jbcznsk/7-segment-clock/imgs/m.png

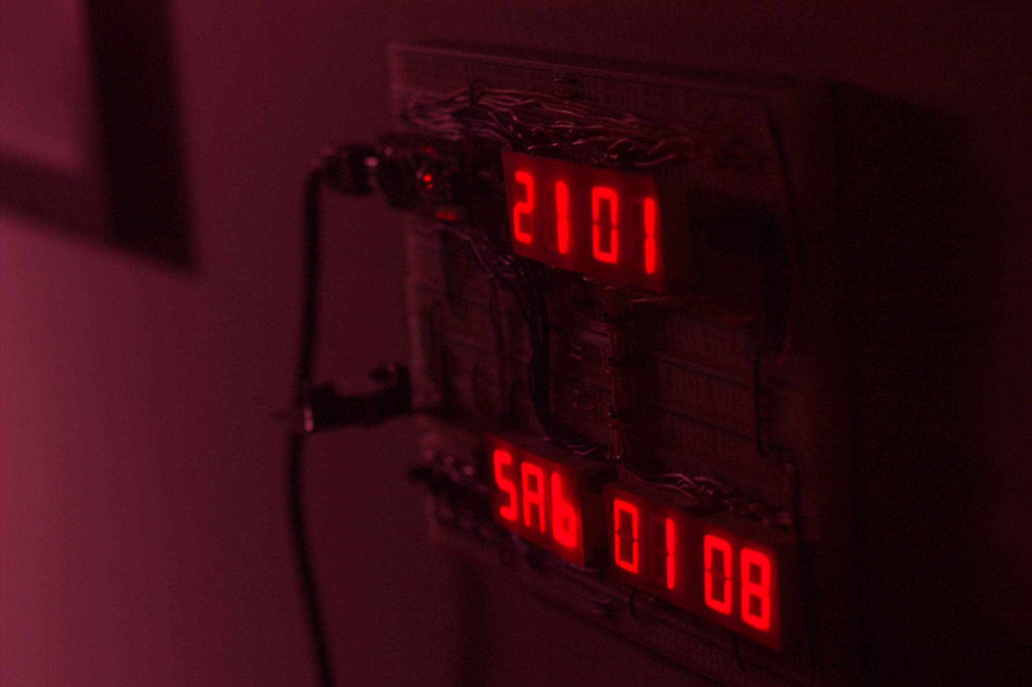
imgs/m.png
