jbcznsk/7-segment-clock/imgs/montagem/README.md

## Montagem do Circuito
### 1º Passo


### 2º Passo


### 3º Passo



### 4º Passo



### 5º Passo



### 6º Passo





### 7º Passo



### 8º Passo





### 9º Passo
