jbcznsk/7-segment-clock/(commit log)

2020-07-28 a3 é cocô
    por algum motivo o pino A3 é uma bosta como pino digital e parou de funcionar ???
2020-09-29 adição de links e datasheets
